facelesstech/gbc_retropie_aio_revC/README.md

# gbc_retropie_aio_revC
gbc_retropie_aio_revC

GBC Retropie AIO Blog post - https://facelesstech.wordpress.com/2022/02/11/gbc-retropie-aio-rev-c/ 
GBC Retropie AIO build guide - https://facelesstech.wordpress.com/2021/09/19/gbc-retropie-aio-rev-c-build-guide/
