facelesstech/gbc_retropie_aio_revC/3d_print_files/freecad_files/GBC_x_y_button_wells.FCStd

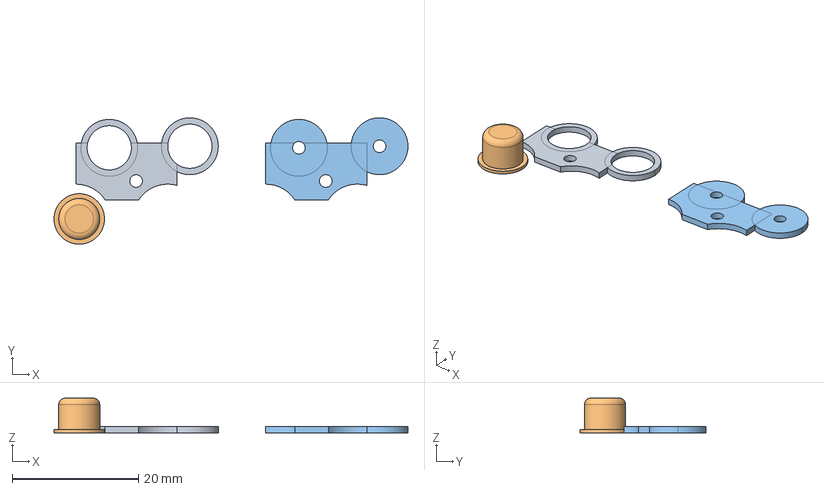
[picture p1: CAD file, 2022-01-15]
3d_print_files/freecad_files/GBC_x_y_button_wells.FCStd
56.0 x 20.0 x 5.50 mm
Cut(button_well)
Fillet(button)
Cut004(button_template)
