facelesstech/gbc_retropie_aio_revC/3d_print_files/stl_files/gbc_power_port6.stl

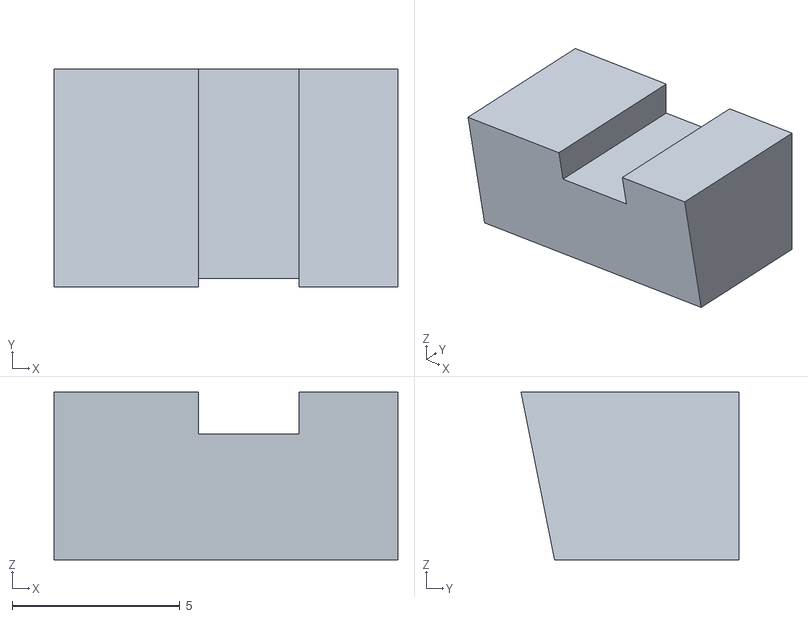
[picture p2: CAD file, 2022-01-15]
3d_print_files/stl_files/gbc_power_port6.stl
10.2 x 6.50 x 5.00
