facelesstech/gbc_retropie_aio_revC/3d_print_files/freecad_files/GBC_gameboy_cart_cover.FCStd

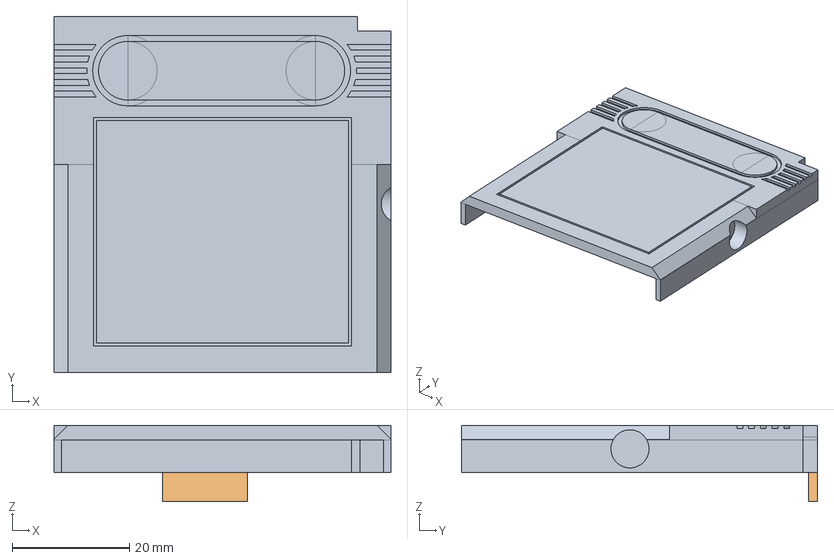
[picture p3: CAD file, 2022-01-15]
3d_print_files/freecad_files/GBC_gameboy_cart_cover.FCStd
57.5 x 60.8 x 13.0 mm
Cube(sd_card_cover)001
