facelesstech/gbc_retropie_aio_revC/3d_print_files/stl_files/gbc_button_x_y4.stl

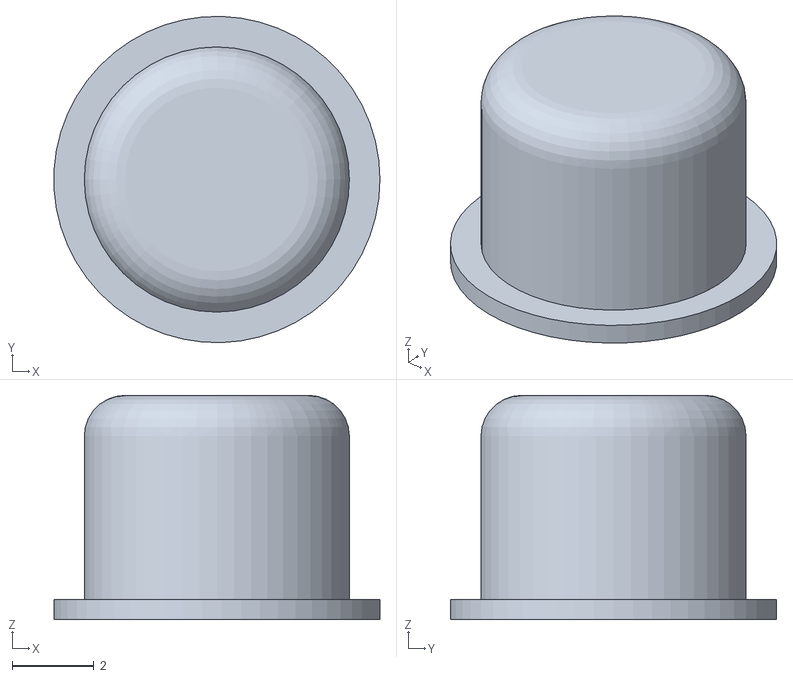
[picture p4: CAD file, 2022-01-15]
3d_print_files/stl_files/gbc_button_x_y4.stl
7.99 x 8.00 x 5.50
