facelesstech/gbc_retropie_aio_revC/3d_print_files/stl_files/gbc_button_wells12.stl

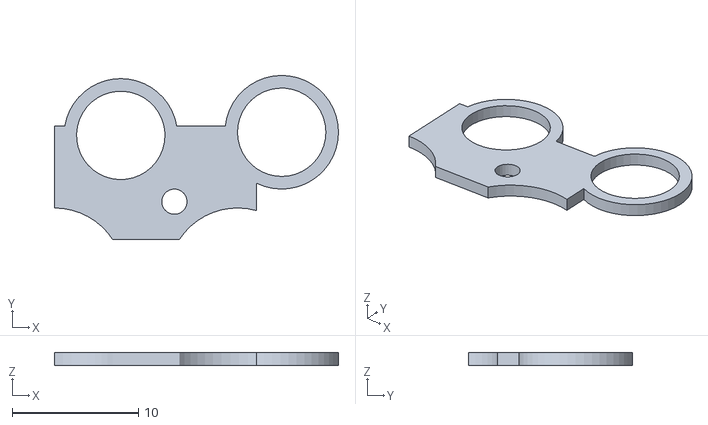
[picture p5: CAD file, 2022-01-15]
3d_print_files/stl_files/gbc_button_wells12.stl
22.5 x 13.0 x 1.00
