facelesstech/gbc_retropie_aio_revC/3d_print_files/freecad_files/GBC_zero_L_R_bracket.FCStd

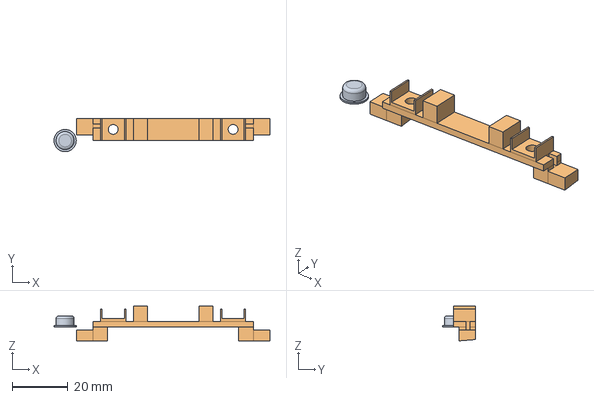
[picture p6: CAD file, 2022-01-15]
3d_print_files/freecad_files/GBC_zero_L_R_bracket.FCStd
77.5 x 12.0 x 12.5 mm
Fillet(button)
Cut008(braket)
