facelesstech/gbc_retropie_aio_revC/3d_print_files/stl_files/gbc_button_l_r.stl

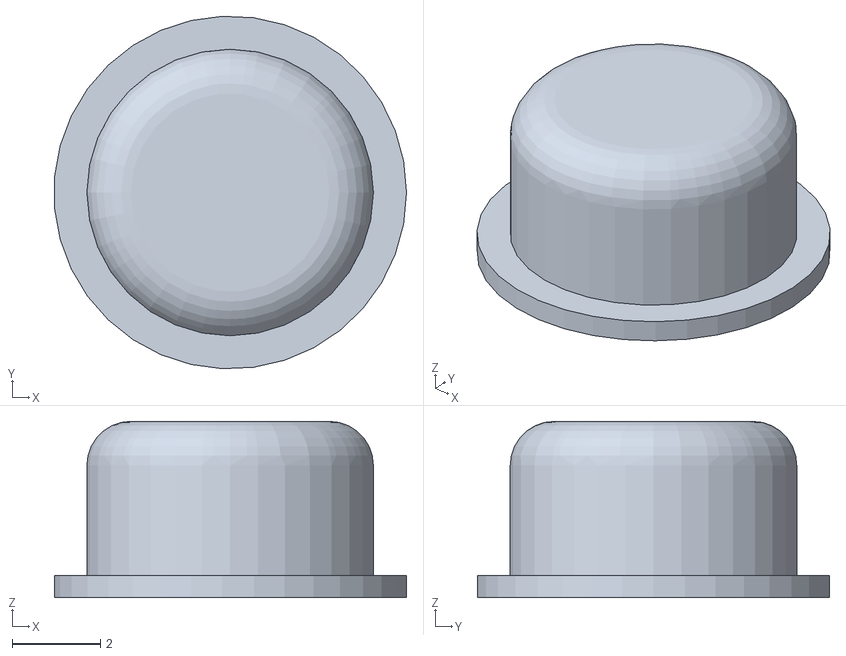
[picture p7: CAD file, 2022-01-15]
3d_print_files/stl_files/gbc_button_l_r.stl
7.98 x 7.99 x 4.00
