facelesstech/gbc_retropie_aio_revC/3d_print_files/stl_files/gbc_zero_l_r_bracket10.stl

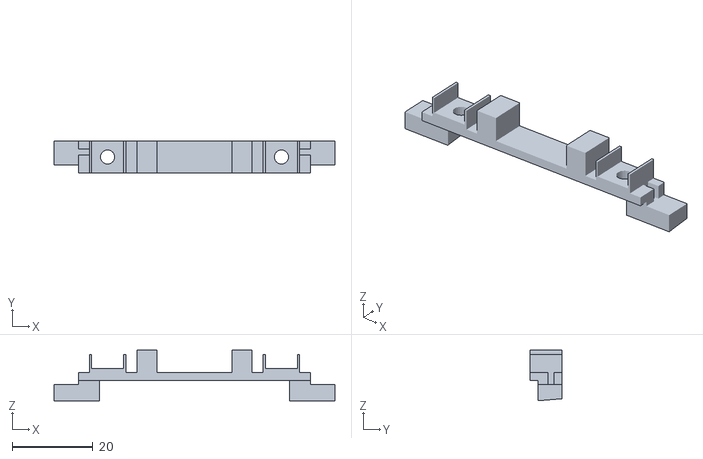
[picture p8: CAD file, 2022-01-15]
3d_print_files/stl_files/gbc_zero_l_r_bracket10.stl
69.5 x 8.00 x 12.5
