facelesstech/gbc_retropie_aio_revC/(list of files, cad)

Other CAD files:
3d_print_files/freecad_files/GBC_power_port.FCStd
3d_print_files/stl_files/gbc_gameboy_cart_cover7.stl
