facelesstech/gbc_retropie_aio_revC/kicad_files/gbc_retrozero_buttons_led_rev_c/gbc_retrozero_buttons_led.kicad_pcb

## KiCad design kicad_files/gbc_retrozero_buttons_led_rev_c/gbc_retrozero_buttons_led.kicad_pcb (2022-01-15)

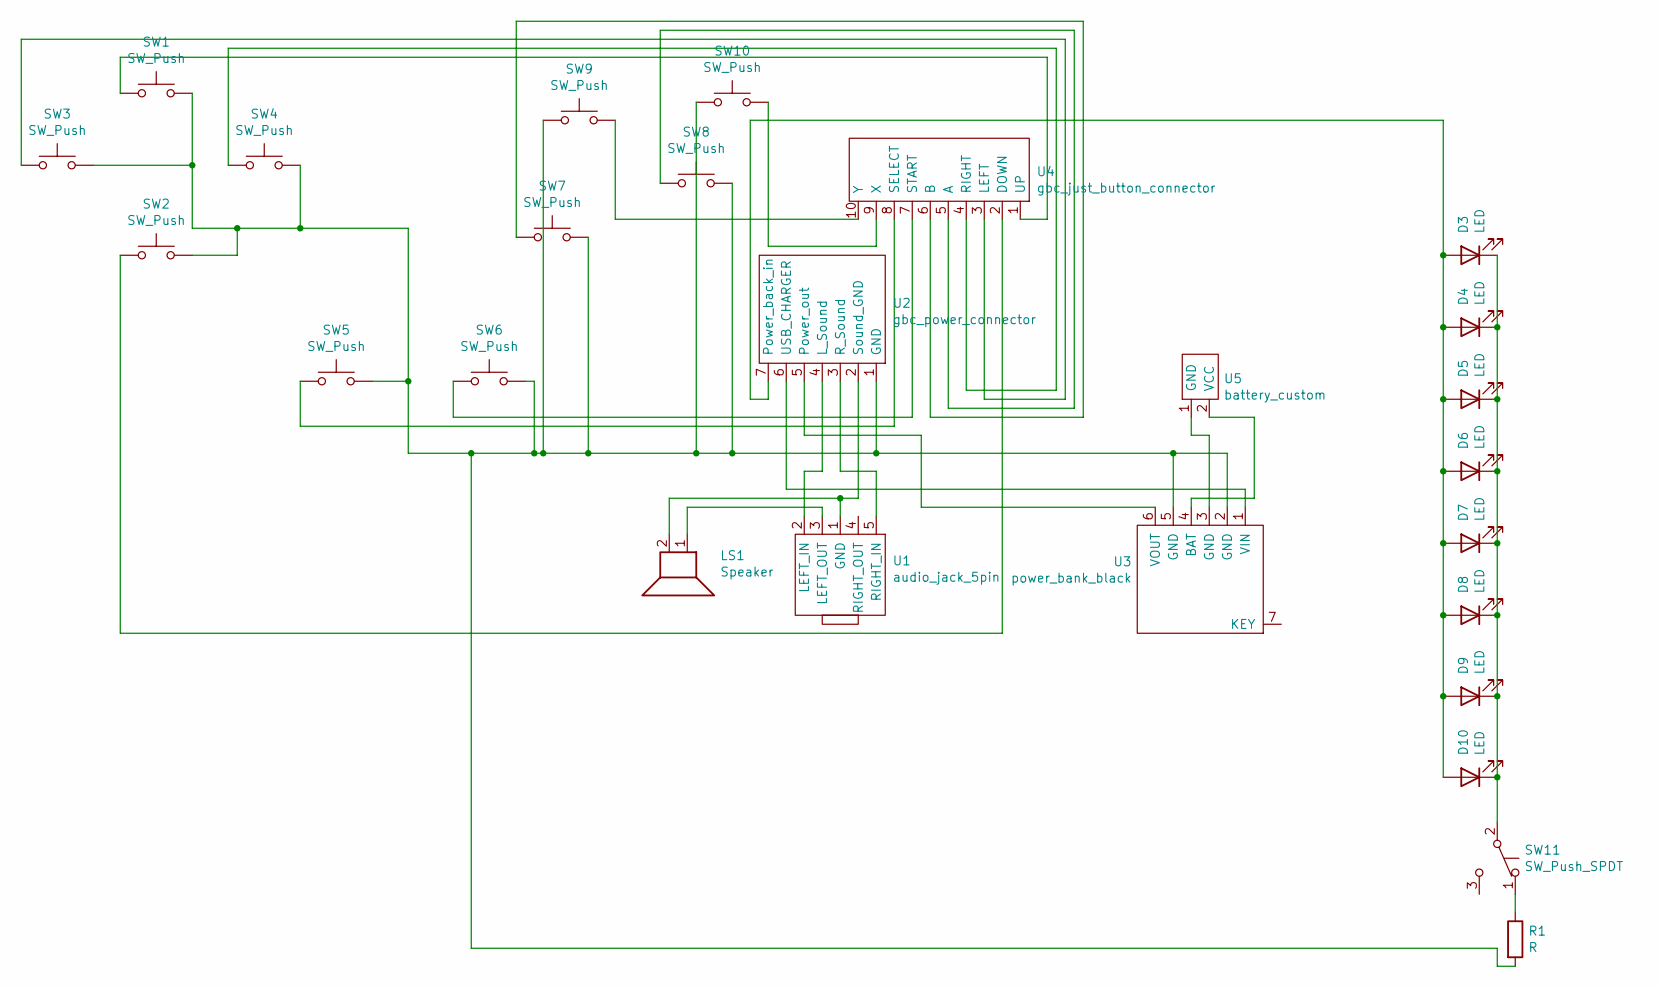
[picture p9: schematic gbc_retrozero_buttons_led.sch]

Parts:
D3, D4, D5, D6, D7, D8, D9, D10: LED; LED_0603_1608Metric_Pad1.05x0.95mm_HandSolder
LS1: Speaker; speaker_2pin
R1: R; R_1206_3216Metric_Pad1.30x1.75mm_HandSolder
SW1, SW2, SW3, SW4, SW5, SW6: SW_Push; gbc_pad_buttons_small
SW7, SW8: SW_Push; gbc_start_button_custom
SW9: SW_Push; button_soft_touch_drill_hole_custom
SW10: SW_Push; button_soft_touch_2_hole_custom
SW11: SW_Push_SPDT; tiny_smd_slide_switch_adjustable
U1: audio_jack_5pin; 5_pin_3.5_jack
U2: gbc_power_connector; GBC_power_and_sound_slim
U3: power_bank_black; power_bank_black_smd
U4: gbc_just_button_connector; GBC_button_headers_only_slim
U5: battery_custom; vcc_gnd_2pin_custom

Connections:
unnamed: D3.1 (K), D4.1 (K), D5.1 (K), D6.1 (K), D7.1 (K), D8.1 (K), D9.1 (K), D10.1 (K), SW11.2 (B)
unnamed: D3.2 (A), D4.2 (A), D5.2 (A), D6.2 (A), D7.2 (A), D8.2 (A), D9.2 (A), D10.2 (A), U2.7 (Power_back_in)
unnamed: LS1.1, U1.3 (LEFT_OUT)
unnamed: LS1.2, U1.1 (GND), U2.2 (Sound_GND)
unnamed: R1.1, SW11.1 (A)
unnamed: R1.2, SW1.2, SW2.2, SW3.2, SW4.2, SW5.2, SW6.2, SW7.2, SW8.2, SW9.1, SW10.1, U2.1 (GND), U3.2 (GND), U3.5 (GND)
unnamed: SW1.1, U4.1 (UP)
unnamed: SW2.1, U4.2 (DOWN)
unnamed: SW3.1, U4.3 (LEFT)
unnamed: SW4.1, U4.4 (RIGHT)
unnamed: SW5.1, U4.8 (SELECT)
unnamed: SW6.1, U4.7 (START)
unnamed: SW7.1, U4.6 (B)
unnamed: SW8.1, U4.5 (A)
unnamed: SW9.2, U4.10 (Y)
unnamed: SW10.2, U4.9 (X)
unnamed: U1.2 (LEFT_IN), U2.4 (L_Sound)
unnamed: U1.5 (RIGHT_IN), U2.3 (R_Sound)
unnamed: U2.5 (Power_out), U3.6 (VOUT)
unnamed: U2.6 (USB_CHARGER), U3.1 (VIN)
unnamed: U3.3 (GND), U5.1 (GND)
unnamed: U3.4 (BAT), U5.2 (VCC)

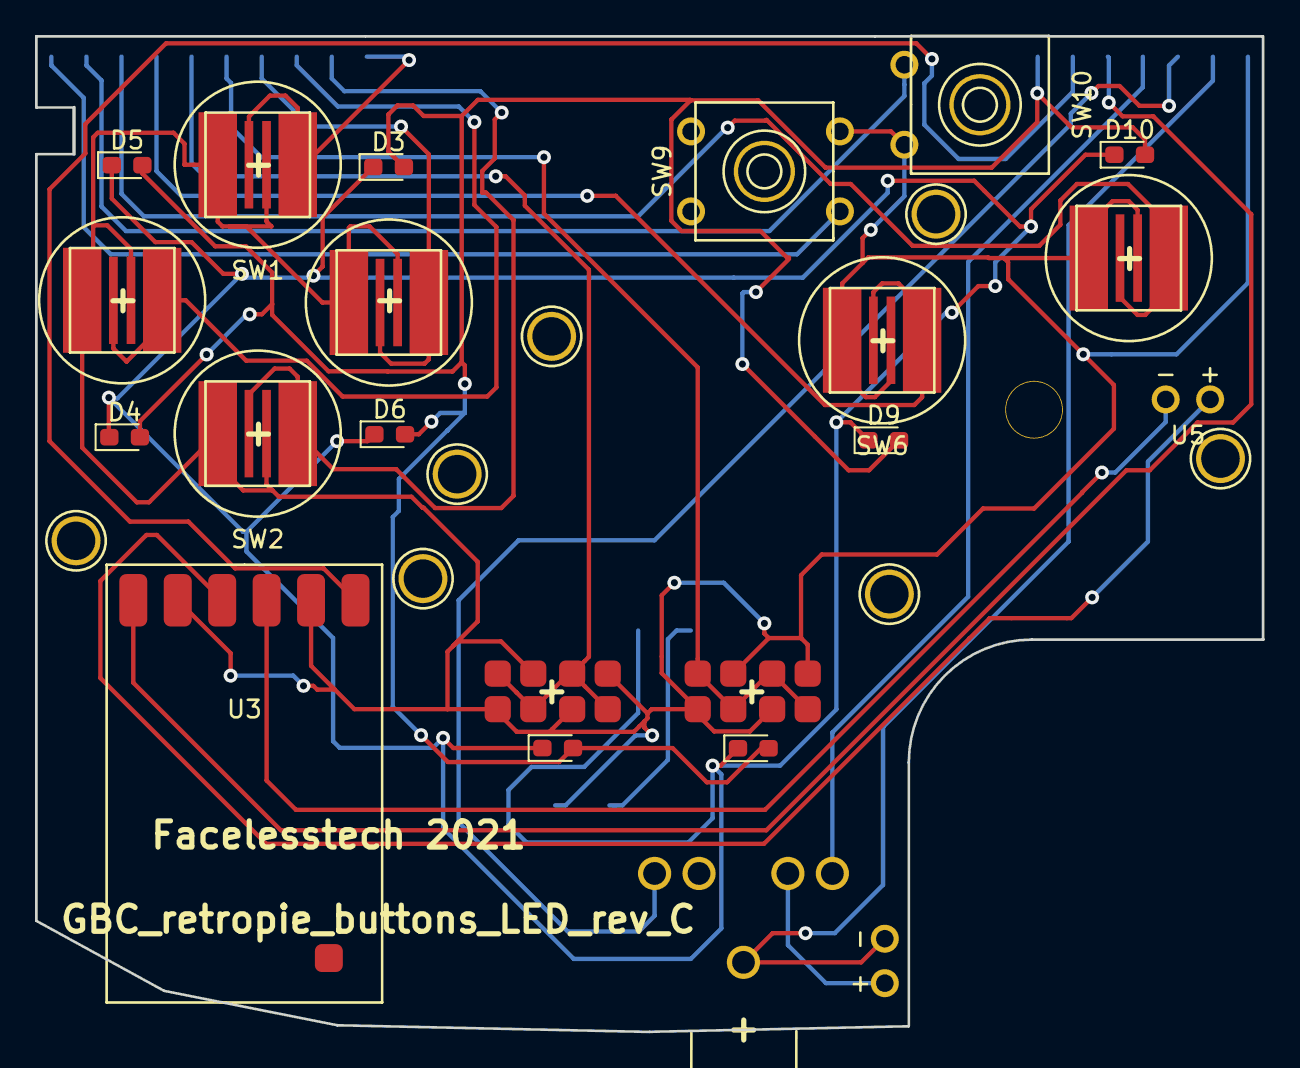
[picture p10: board gbc_retrozero_buttons_led.kicad_pcb from above]

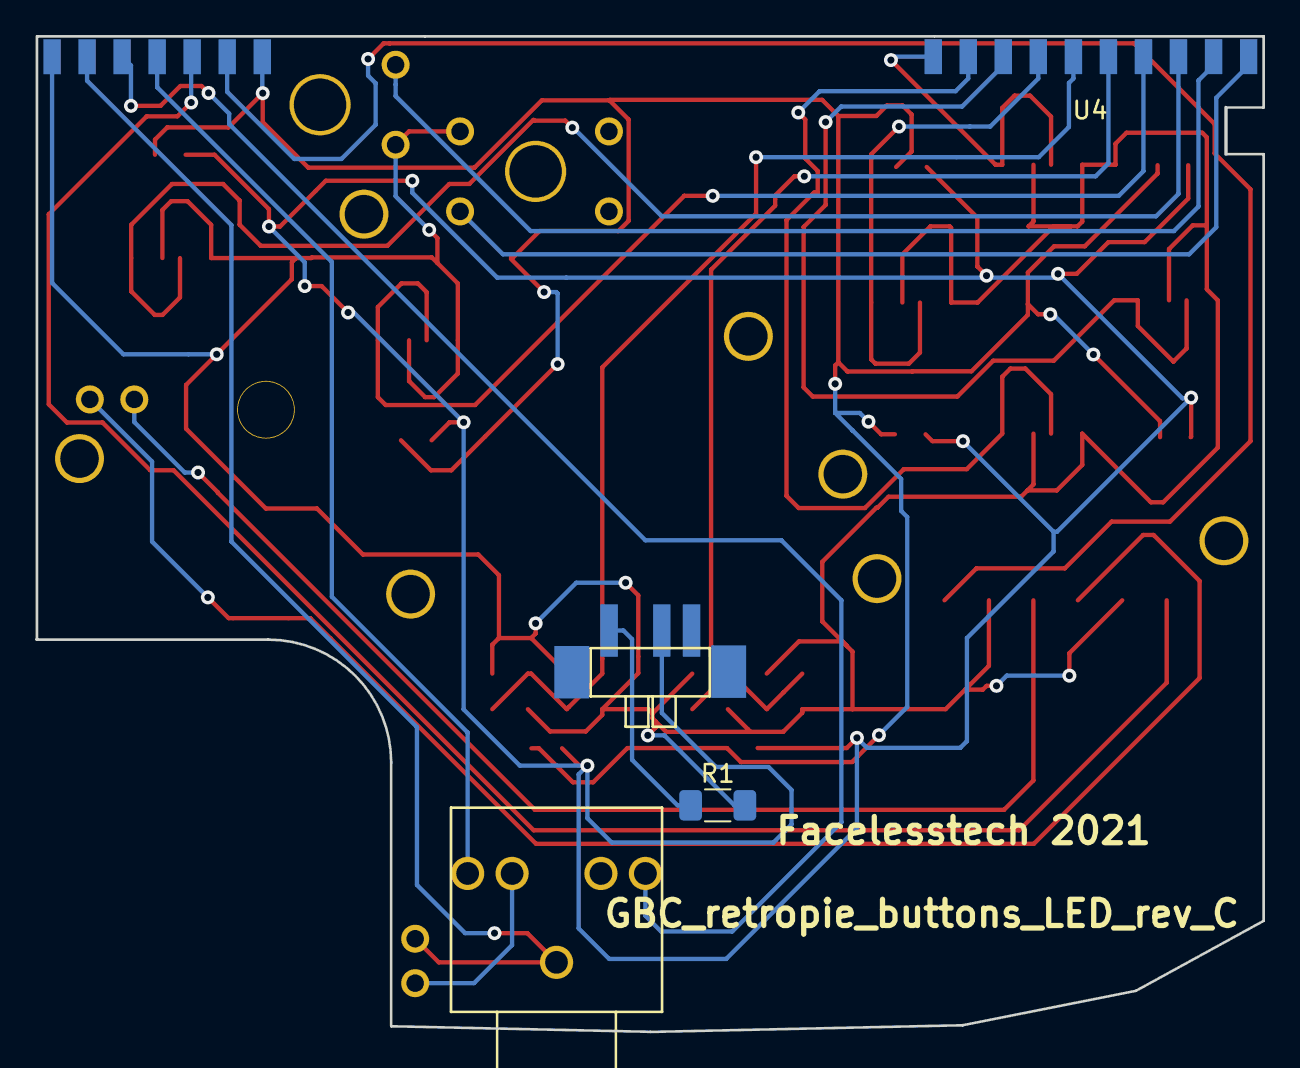
[picture p11: board gbc_retrozero_buttons_led.kicad_pcb from below]

Board: 2 copper layers, 70.1 x 56.9 mm, 26 parts (5 on the bottom side), 22 nets.
