facelesstech/gbc_retropie_aio_revC/kicad_files/gbc_retrozero_screen_rev_e/gbc_retrozero_screen_rev_b.kicad_pcb

## KiCad design kicad_files/gbc_retrozero_screen_rev_e/gbc_retrozero_screen_rev_b.kicad_pcb (2022-02-14)

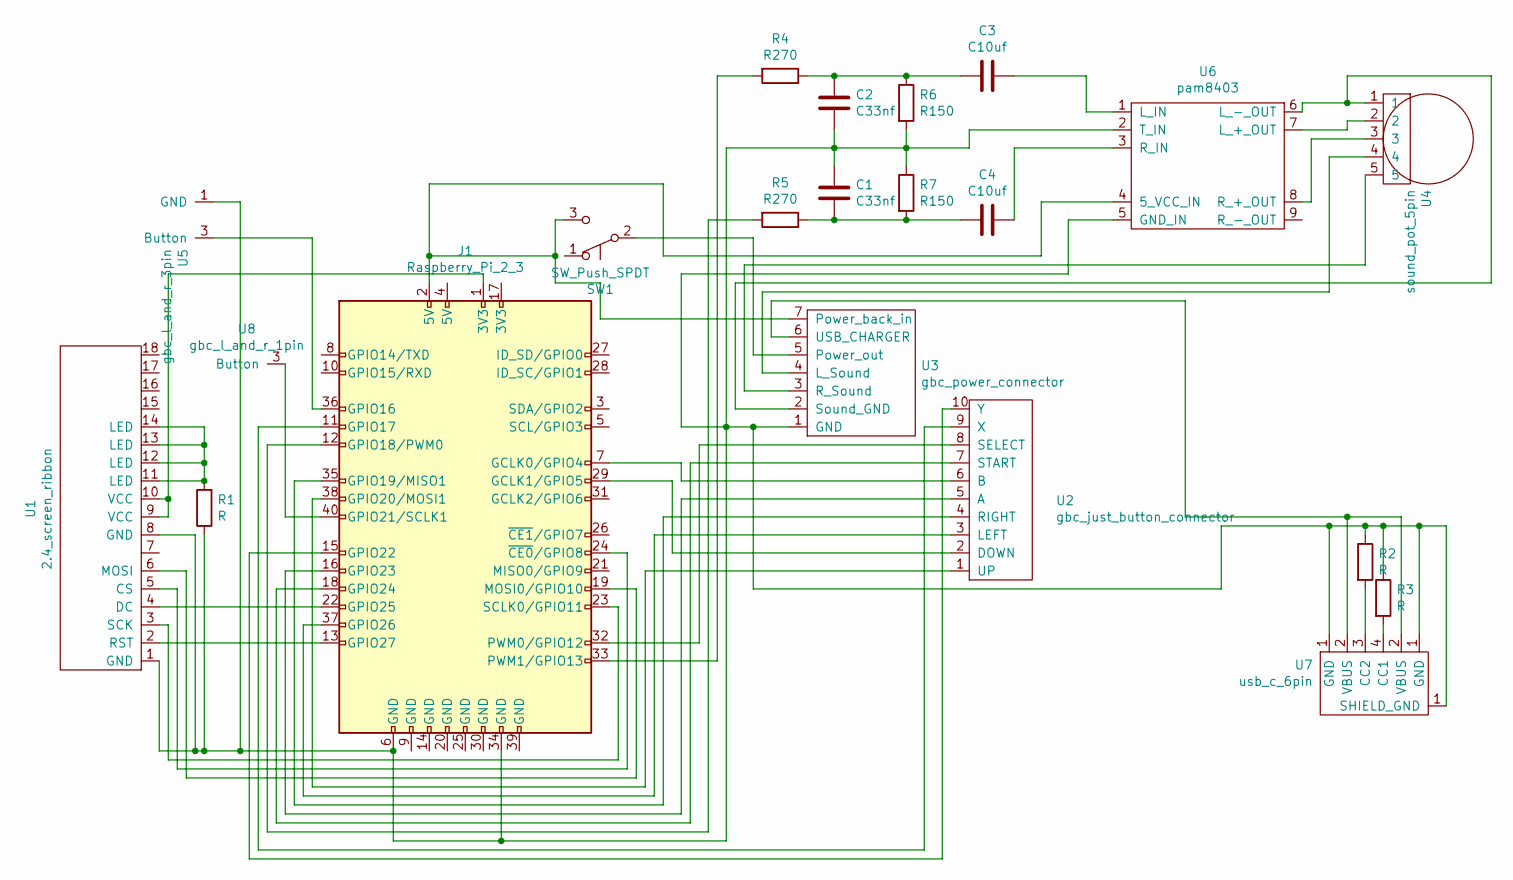
[picture p12: schematic gbc_retrozero_screen_rev_b.sch]

Parts:
C1, C2: C33nf; C_1206_3216Metric_Pad1.42x1.75mm_HandSolder
C3, C4: C10uf; C_1206_3216Metric_Pad1.42x1.75mm_HandSolder
J1: Raspberry_Pi_2_3; raspberry_pi_gpio_SMD_outline_under_holes
R1, R2, R3: R; R_1206_3216Metric_Pad1.42x1.75mm_HandSolder
R4, R5: R270; R_1206_3216Metric_Pad1.42x1.75mm_HandSolder
R6, R7: R150; R_1206_3216Metric_Pad1.42x1.75mm_HandSolder
SW1: SW_Push_SPDT; 3_pin_switch_smd_side_mount
U1: 2.4_screen_ribbon; 2.8_screen_ribbon_breakout
U2: gbc_just_button_connector; GBC_button_headers_only_slim
U3: gbc_power_connector; GBC_power_and_sound_slim
U4: sound_pot_5pin; GBC_pot_custom
U5: gbc_l_and_r_3pin; GBC_L_and_R_3pin
U6: pam8403; PAM8403_custom_smd
U7: usb_c_6pin; USB_C_6PIN_custom
U8: gbc_l_and_r_1pin; GBC_L_and_R_1pin

Connections:
unnamed: C1.1, C2.2, J1.6 (GND), J1.34 (GND), R1.1, R2.1, R3.1, R6.2, R7.1, U1.1 (GND), U1.8 (GND), U3.1 (GND), U5.1 (GND), U6.2 (T_IN), U6.5 (GND_IN), U7.1 (GND)
unnamed: C1.2, C4.2, R5.1, R7.2
unnamed: C2.1, C3.2, R4.1, R6.1
unnamed: C3.1, U6.1 (L_IN)
unnamed: C4.1, U6.3 (R_IN)
unnamed: J1.1 (3V3), U1.9 (VCC), U1.10 (VCC)
unnamed: J1.2 (5V), SW1.3 (C), U3.7 (Power_back_in), U6.4 (5_VCC_IN)
unnamed: J1.7 (GCLK0/GPIO4), U2.6 (B)
unnamed: J1.11 (GPIO17), U2.9 (X)
unnamed: J1.12 (GPIO18/PWM0), R5.2
unnamed: J1.13 (GPIO27), U1.2 (RST)
unnamed: J1.15 (GPIO22), U2.10 (Y)
unnamed: J1.16 (GPIO23), U2.5 (A)
unnamed: J1.18 (GPIO24), U2.7 (START)
unnamed: J1.19 (MOSI0/GPIO10), U1.6 (MOSI)
unnamed: J1.22 (GPIO25), U1.4 (DC)
unnamed: J1.23 (SCLK0/GPIO11), U1.3 (SCK)
unnamed: J1.24 (~CE0~/GPIO8), U1.5 (CS)
unnamed: J1.29 (GCLK1/GPIO5), U2.2 (DOWN)
unnamed: J1.32 (PWM0/GPIO12), U2.8 (SELECT)
unnamed: J1.33 (PWM1/GPIO13), R4.2
unnamed: J1.35 (GPIO19/MISO1), U2.4 (RIGHT)
unnamed: J1.36 (GPIO16), U5.3 (Button)
unnamed: J1.37 (GPIO26), U2.3 (LEFT)
unnamed: J1.38 (GPIO20/MOSI1), U2.1 (UP)
unnamed: J1.40 (GPIO21/SCLK1), U8.3
unnamed: R1.2, U1.11 (LED), U1.12 (LED), U1.13 (LED), U1.14 (LED)
unnamed: R2.2, U7.3 (CC2)
unnamed: R3.2, U7.4 (CC1)
unnamed: SW1.2 (B), U3.5 (Power_out)
unnamed: U3.2 (Sound_GND), U4.1, U6.6 (L_-_OUT)
unnamed: U3.3 (R_Sound), U4.5
unnamed: U3.4 (L_Sound), U4.4
unnamed: U3.6 (USB_CHARGER), U7.2 (VBUS)
unnamed: U4.2, U6.7 (L_+_OUT)
unnamed: U4.3, U6.8 (R_+_OUT)

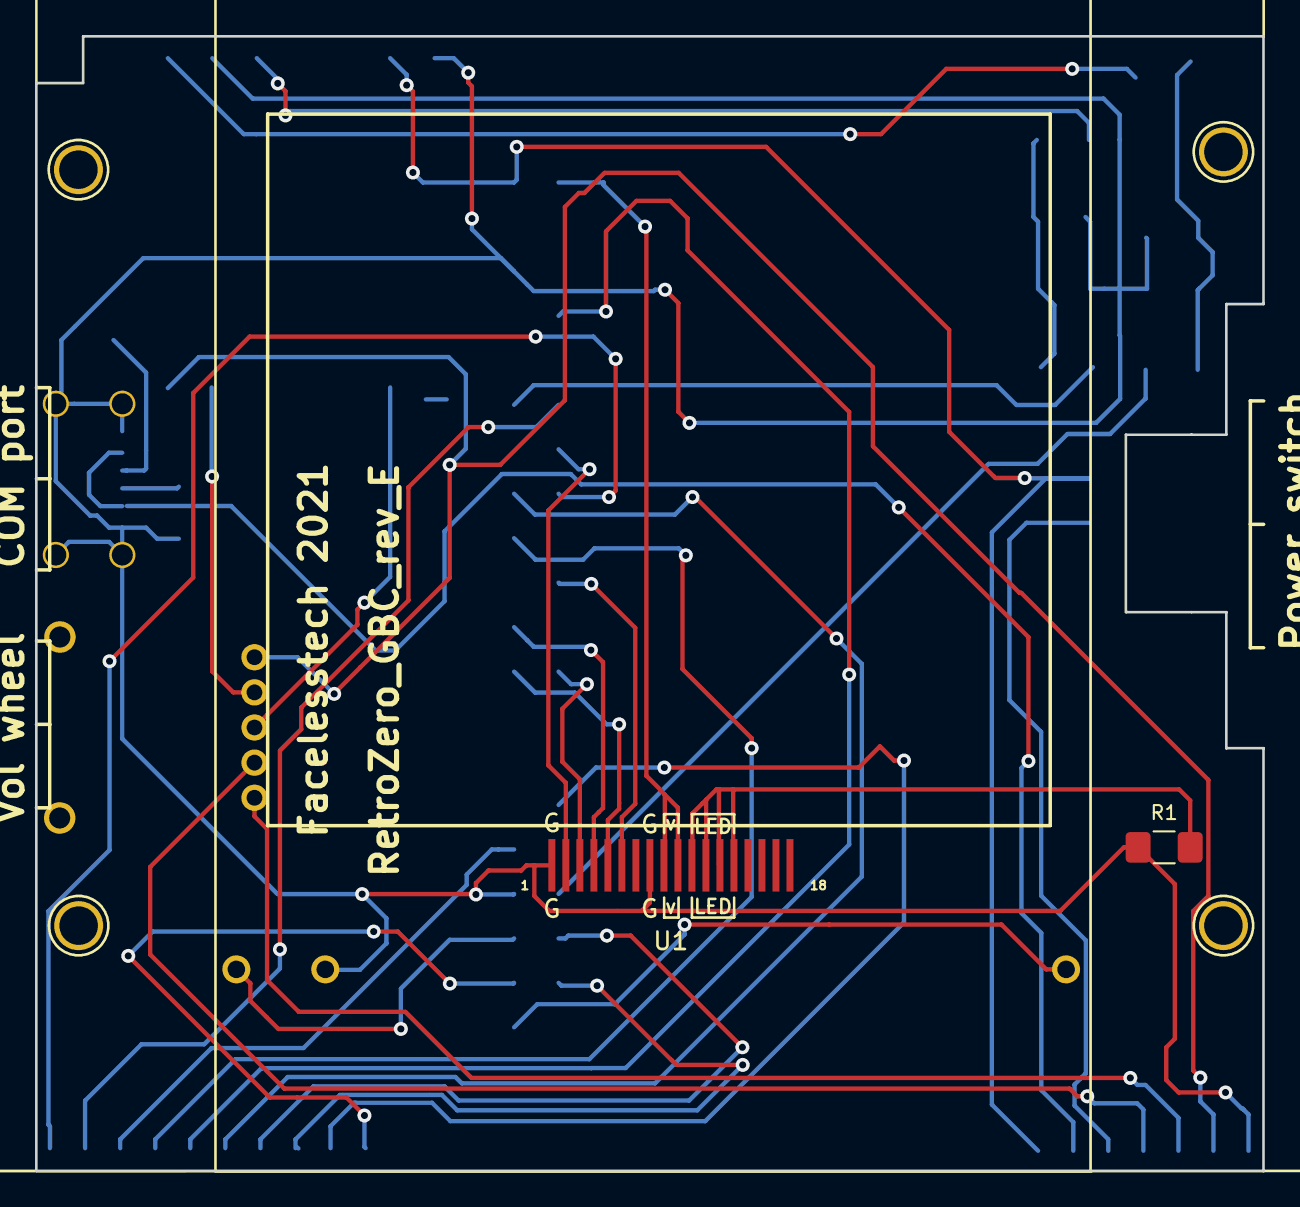
[picture p13: board gbc_retrozero_screen_rev_b.kicad_pcb from above]

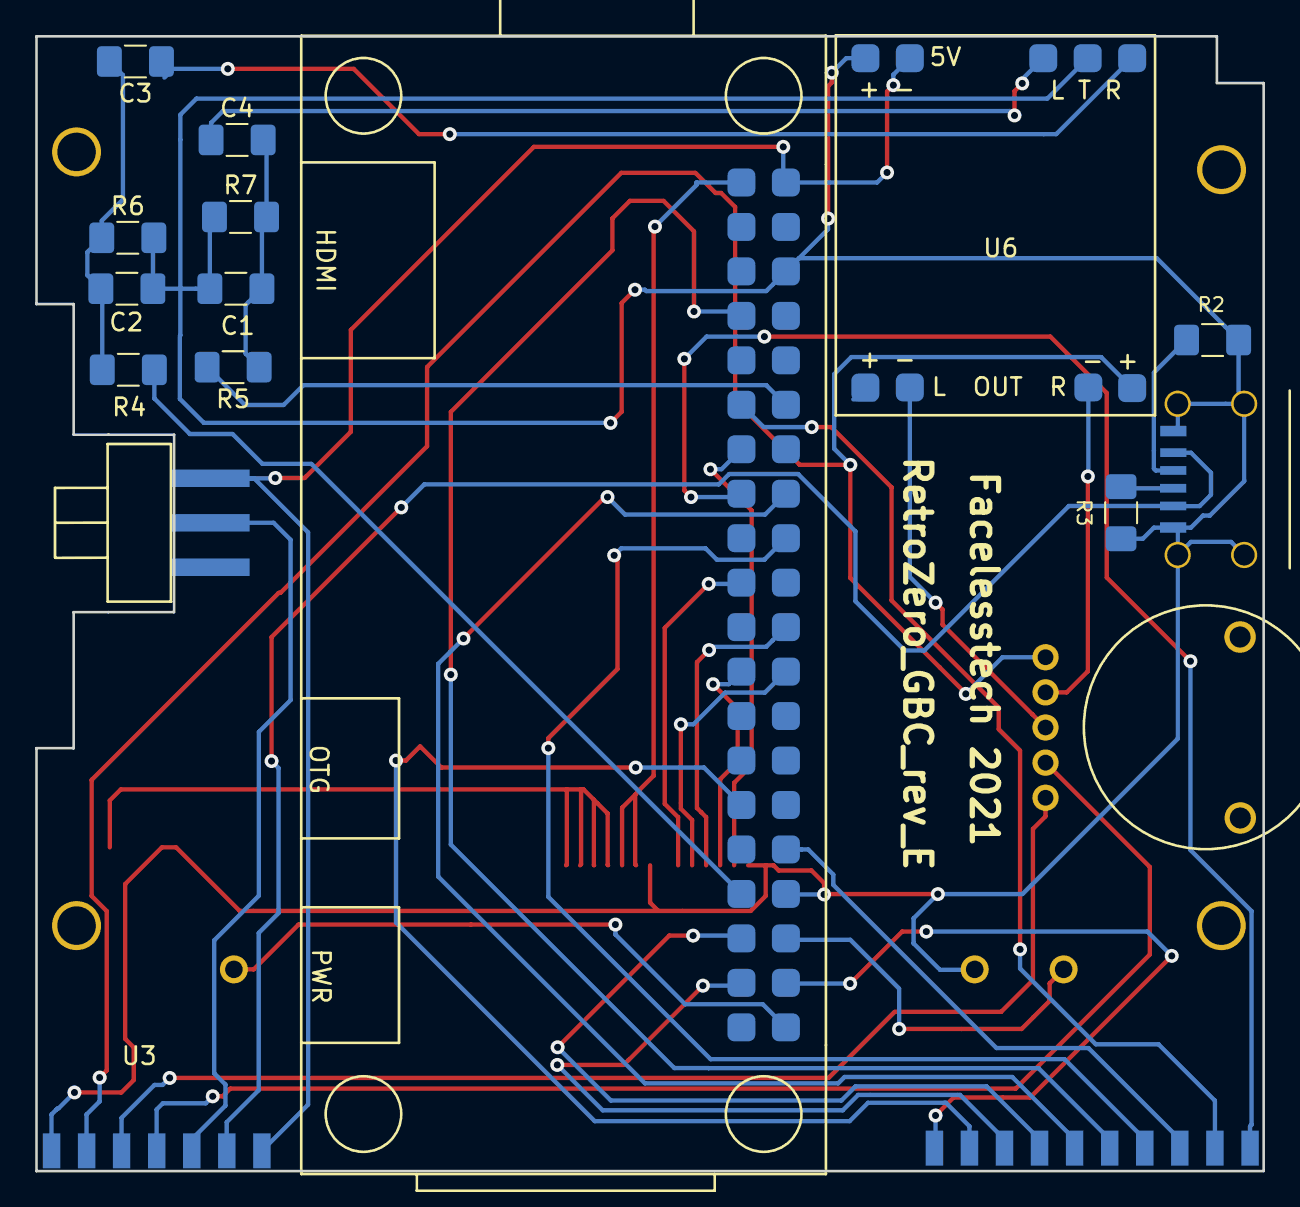
[picture p14: board gbc_retrozero_screen_rev_b.kicad_pcb from below]

Board: 2 copper layers, 70.1 x 64.8 mm, 21 parts (17 on the bottom side), 36 nets.
