facelesstech/gbc_retropie_aio_revC/(commit log)

2022-01-15 PCB files
    [gbc_retrozero_buttons_led-B_Cu.gbr, gbc_retrozero_buttons_led-B_Mask.gbr, gbc_retrozero_buttons_led-B_SilkS.gbr, gbc_retrozero_buttons_led-Edge_Cuts.gbr, gbc_retrozero_buttons_led-F_Cu.gbr, gbc_retrozero_buttons_led-F_Mask.gbr, gbc_retrozero_buttons_led-F_SilkS.gbr, gbc_retrozero_buttons_led-NPTH.drl]
2022-01-15 all the 3d print files
    [GBC_gameboy_cart_cover.FCStd, GBC_power_port.FCStd, GBC_x_y_button_wells.FCStd, GBC_zero_L_R_bracket.FCStd]
2022-01-15 removed folder
    [GBC_gameboy_cart_cover.FCStd, GBC_power_port.FCStd, GBC_x_y_button_wells.FCStd, GBC_zero_L_R_bracket.FCStd]
2022-01-15 added stl files
    [GBC_gameboy_cart_cover.FCStd, GBC_power_port.FCStd, GBC_x_y_button_wells.FCStd, GBC_zero_L_R_bracket.FCStd, gbc_button_l_r.stl, gbc_button_wells12.stl, gbc_button_x_y4.stl, gbc_gameboy_cart_cover7.stl]
2022-02-14 fixed issus with J1-PAD36 and trace
    [gbc_retrozero_screen_rev_b.kicad_pcb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]
2023-05-27 changed the folder name to reflect the board rev name
    [gbc_retrozero_screen_rev_b-B_Cu.gbr, gbc_retrozero_screen_rev_b-B_Mask.gbr, gbc_retrozero_screen_rev_b-B_SilkS.gbr, gbc_retrozero_screen_rev_b-Edge_Cuts.gbr, gbc_retrozero_screen_rev_b-F_Cu.gbr, gbc_retrozero_screen_rev_b-F_Mask.gbr, gbc_retrozero_screen_rev_b-F_SilkS.gbr, gbc_retrozero_screen_rev_b-NPTH.drl]
